oeps-tech/OE-PyBoard/Firmware/README.md

The firmware file was downloaded from the PyBoard v1.1 page: https://micropython.org/download/PYBV11/
