oeps-tech/OE-PyBoard/PCB/OE PyBoard FootprintLib/SW_SPST_TL3305B.step

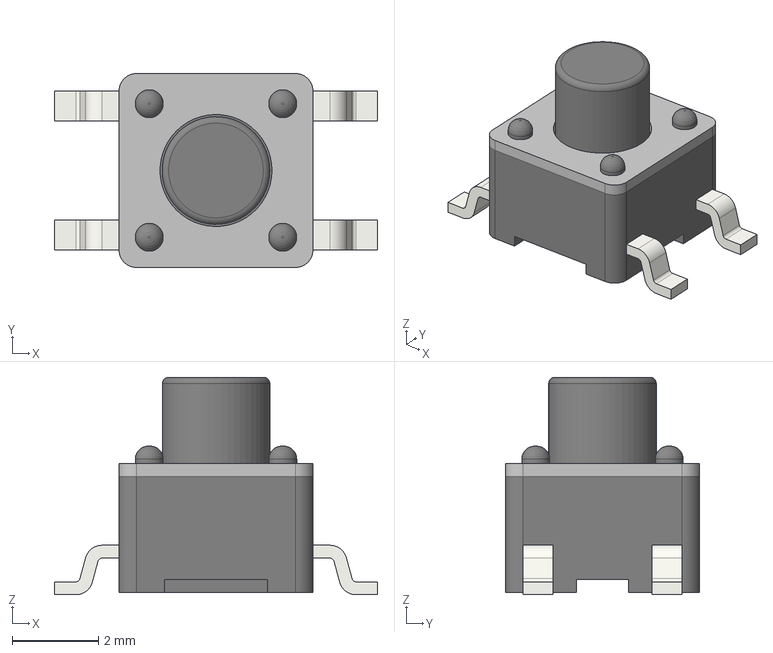
[picture p1: CAD file, 2025-09-24]
PCB/OE PyBoard FootprintLib/SW_SPST_TL3305B.step
7.50 x 4.50 x 5.05 mm
