oeps-tech/OE-PyBoard/PCB/OE PyBoard FootprintLib/ECS-.327-12.5-17X-C-TR.step

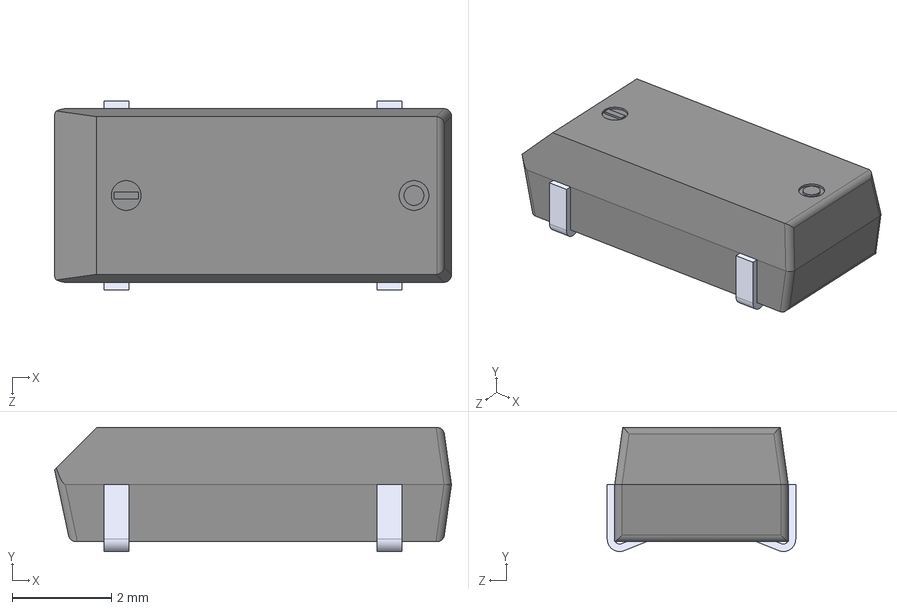
[picture p2: CAD file, 2025-09-12]
PCB/OE PyBoard FootprintLib/ECS-.327-12.5-17X-C-TR.step
8.00 x 2.50 x 3.80 mm
