oeps-tech/OE-PyBoard/PCB/OE PyBoard FootprintLib/475710001.stp

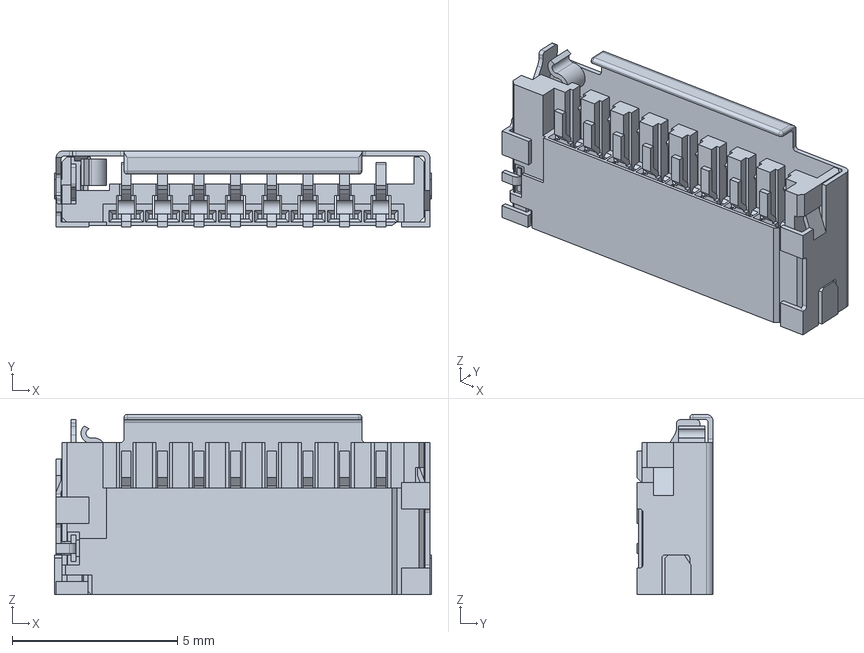
[picture p3: CAD file, 2025-09-12]
PCB/OE PyBoard FootprintLib/475710001.stp
11.4 x 2.30 x 5.45 mm
