oeps-tech/OE-PyBoard/PCB/OE PyBoard.kicad_pcb

## KiCad design PCB/OE PyBoard.kicad_pcb (2025-11-24)

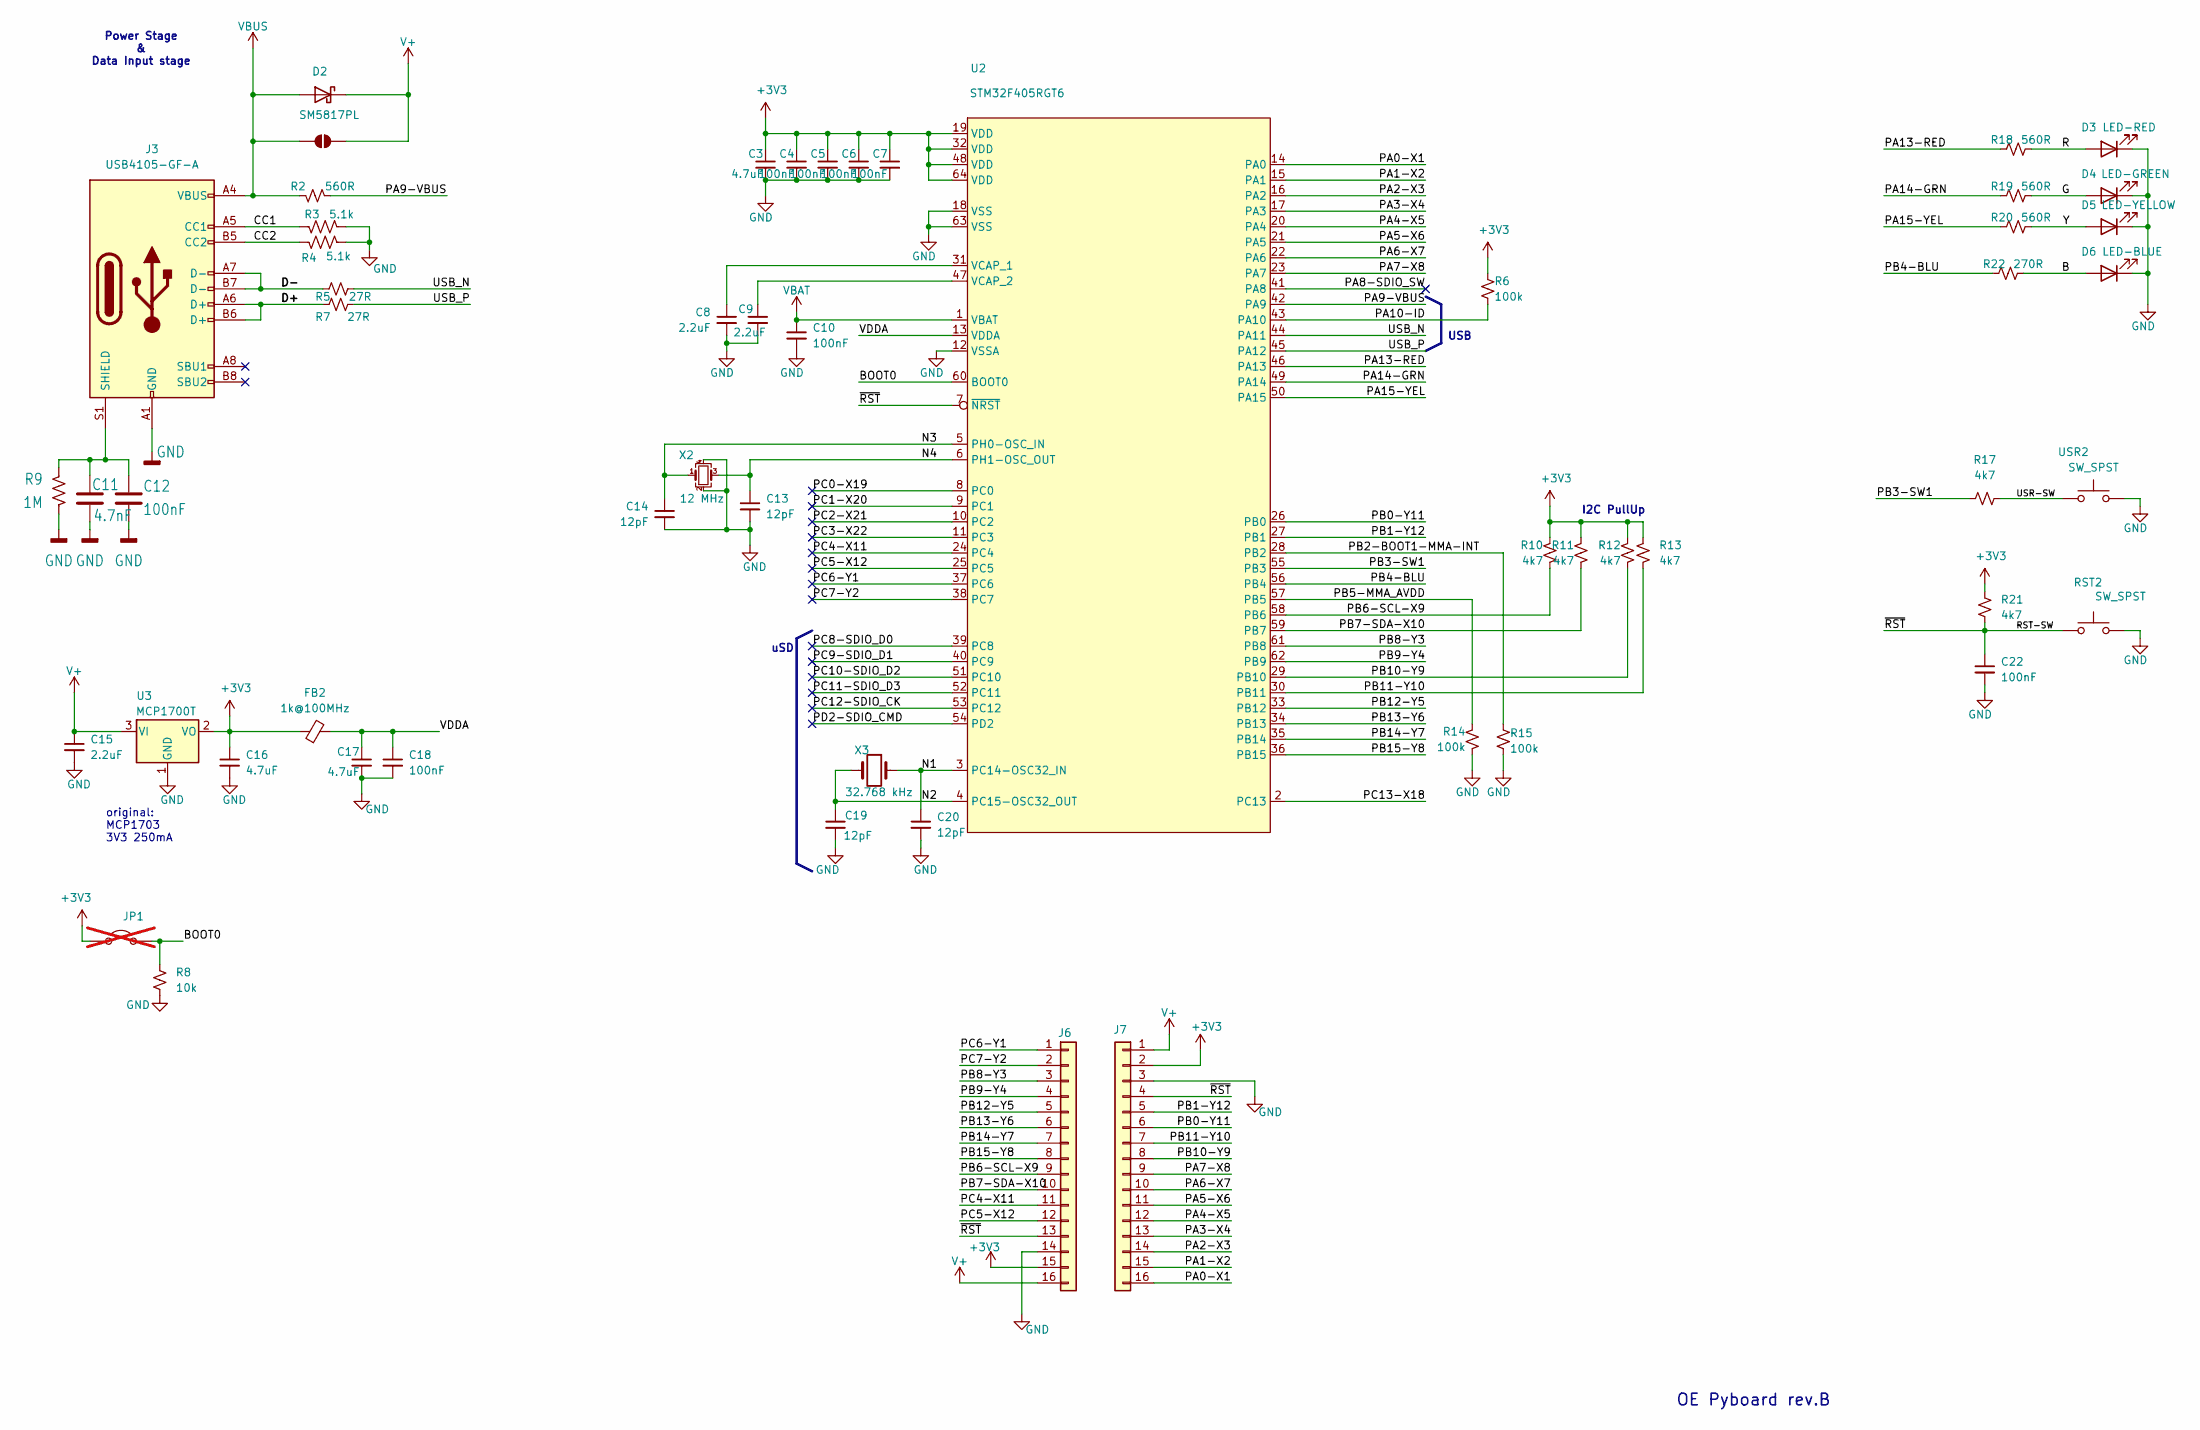
[picture p4: schematic OE PyBoard.kicad_sch]

Parts:
C3, C16, C17: 4.7uF; C_0603_1608Metric; MPN C1608X6S1C475K080AC
C4, C5, C6, C7, C10, C12, C18, C22: 100nF; C_0402_1005Metric; MPN CGA2B3X7R1H104K050BB
C8, C9, C15: 2.2uF; C_0603_1608Metric; MPN GRM188R61E225KA12D
C11: 4.7nF; C_0402_1005Metric; MPN 885012205084
C13, C14, C19, C20: 12pF; C_0402_1005Metric; MPN GRM1555C1H120JA01D
D2: SM5817PL; D_SOD-123; MPN SM5817PL-TP
D3: LED-RED; LED_0603_1608Metric; MPN 5990010007F
D4: LED-GREEN; LED_0603_1608Metric; MPN LSM0603453V
D5: LED-YELLOW; LED_0603_1608Metric; MPN 5990040007F
D6: LED-BLUE; LED_0603_1608Metric; MPN 5988D90107F
FB2: 1k@100MHz; L_0402_1005Metric; MPN BLM15HD102SN1D
J3: USB4105-GF-A; USB_C_Receptacle_GCT_USB4105-xx-A_16P_TopMnt_Horizontal; MPN USB4105-GF-A
J6, J7: Conn_01x08; PinHeader_1x16_P2.54mm_Vertical; MPN CES-116-01-T-S
JP1: Jumper; PinHeader_1x02_P2.54mm_Vertical; not fitted
JP2: 0R; SolderJumper-2_P1.3mm_Open_RoundedPad1.0x1.5mm
R2, R18, R19, R20: 560R; R_0402_1005Metric; MPN CRCW0402560RFKED
R3, R4: 5.1k; R_0402_1005Metric; MPN ERJ-2RKF5101X
R5, R7: 27R; R_0402_1005Metric; MPN RMCF0402FT27R0
R6, R14, R15: 100k; R_0402_1005Metric; MPN AC0402FR-07100KL
R8: 10k; R_0402_1005Metric; MPN ERJ-2RKF1002X
R9: 1M; R_0402_1005Metric; MPN CRCW04021M00FKED
R10, R11, R12, R13, R17, R21: 4k7; R_0402_1005Metric; MPN ERJ-2RKF4701X
R22: 270R; R_0402_1005Metric; MPN CRCW0402270RFKEDC
RST2: SW_SPST; SW_SPST_TL3305B; MPN TL3305BF260QG
U2: STM32F405RGT6; LQFP-64_10x10mm_P0.5mm; MPN STM32F405RGT6
U3: MCP1700T; SOT-23; MPN MCP1700T-3302E/TT
USR2: SW_SPST; SW_SPST_TL3305B; MPN TL3305BF260QG
X2: 12 MHz; Crystal_SMD_Abracon_ABM8AIG-4Pin_3.2x2.5mm; MPN ABM8AIG-12.000MHZ-12-2Z-T3
X3: 32.768 kHz; Crystal_SMD_2012-2Pin_2.0x1.2mm_HandSoldering; MPN 9HT11-32.768KBZF-T

Connections:
+3V3: C3.1, C4.1, C5.1, C6.1, C7.1, C16.1, FB2.1, J6.15, J7.2, JP1.2 (B), R6.1, R10.1, R11.1, R12.1, R13.1, R21.2, U2.19 (VDD), U2.32 (VDD), U2.48 (VDD), U2.64 (VDD), U3.2 (VO)
/B: D6.2 (A), R22.2
/BOOT0: JP1.1 (A), R8.1, U2.60 (BOOT0)
/CC1: J3.A5 (CC1), R3.1
/CC2: J3.B5 (CC2), R4.1
/D+: J3.A6 (D+), J3.B6 (D+), R7.2
/D-: J3.A7 (D-), J3.B7 (D-), R5.2
/G: D4.2 (A), R19.2
/N3: C14.1, U2.5 (PH0-OSC_IN), X2.1
/N4: C13.1, U2.6 (PH1-OSC_OUT), X2.3
/PA0-X1: J7.16, U2.14 (PA0)
/PA1-X2: J7.15, U2.15 (PA1)
/PA2-X3: J7.14, U2.16 (PA2)
/PA3-X4: J7.13, U2.17 (PA3)
/PA4-X5: J7.12, U2.20 (PA4)
/PA5-X6: J7.11, U2.21 (PA5)
/PA6-X7: J7.10, U2.22 (PA6)
/PA7-X8: J7.9, U2.23 (PA7)
/PA8-SDIO_SW: U2.41 (PA8)
/PA9-VBUS: R2.1, U2.42 (PA9)
/PA10-ID: R6.2, U2.43 (PA10)
/PA13-RED: R18.1, U2.46 (PA13)
/PA14-GRN: R19.1, U2.49 (PA14)
/PA15-YEL: R20.1, U2.50 (PA15)
/PB0-Y11: J7.6, U2.26 (PB0)
/PB1-Y12: J7.5, U2.27 (PB1)
/PB2-BOOT1-MMA-INT: R15.1, U2.28 (PB2)
/PB3-SW1: R17.1, U2.55 (PB3)
/PB4-BLU: R22.1, U2.56 (PB4)
/PB5-MMA_AVDD: R14.1, U2.57 (PB5)
/PB6-SCL-X9: J6.9, R10.2, U2.58 (PB6)
/PB7-SDA-X10: J6.10, R11.2, U2.59 (PB7)
/PB8-Y3: J6.3, U2.61 (PB8)
/PB9-Y4: J6.4, U2.62 (PB9)
/PB10-Y9: J7.8, R12.2, U2.29 (PB10)
/PB11-Y10: J7.7, R13.2, U2.30 (PB11)
/PB12-Y5: J6.5, U2.33 (PB12)
/PB13-Y6: J6.6, U2.34 (PB13)
/PB14-Y7: J6.7, U2.35 (PB14)
/PB15-Y8: J6.8, U2.36 (PB15)
/PC0-X19: U2.8 (PC0)
/PC1-X20: U2.9 (PC1)
/PC2-X21: U2.10 (PC2)
/PC3-X22: U2.11 (PC3)
/PC4-X11: J6.11, U2.24 (PC4)
/PC5-X12: J6.12, U2.25 (PC5)
/PC6-Y1: J6.1, U2.37 (PC6)
/PC7-Y2: J6.2, U2.38 (PC7)
/PC8-SDIO_D0: U2.39 (PC8)
/PC9-SDIO_D1: U2.40 (PC9)
/PC10-SDIO_D2: U2.51 (PC10)
/PC11-SDIO_D3: U2.52 (PC11)
/PC12-SDIO_CK: U2.53 (PC12)
/PC13-X18: U2.2 (PC13)
/PD2-SDIO_CMD: U2.54 (PD2)
/R: D3.2 (A), R18.2
/RST-SW: C22.1, J6.13, J7.4, R21.1, RST2.1, U2.7 (~NRST)
/USB_N: R5.1, U2.44 (PA11)
/USB_P: R7.1, U2.45 (PA12)
/USR-SW: R17.2, USR2.1
/VDDA: C17.1, C18.1, FB2.2, U2.13 (VDDA)
/Y: D5.2 (A), R20.2
GND: C3.2, C4.2, C5.2, C6.2, C7.2, C8.2, C9.2, C10.2, C11.2, C12.1, C13.2, C14.2, C15.2, C16.2, C17.2, C18.2, C19.2, C20.2, C22.2, D3.1 (K), D4.1 (K), D5.1 (K), D6.1 (K), J3.A1 (GND), J3.A12 (GND), J3.B1 (GND), J3.B12 (GND), J6.14, J7.3, R3.2, R4.2, R8.2, R9.1, R14.2, R15.2, RST2.2, U2.12 (VSSA), U2.18 (VSS), U2.63 (VSS), U3.1 (GND), USR2.2, X2.2, X2.4
unnamed: C11.1, C12.2, J3.S1 (SHIELD), R9.2
unnamed: C8.1, U2.31 (VCAP_1)
unnamed: C9.1, U2.47 (VCAP_2)
V+: C15.1, D2.1 (K), J6.16, J7.1, JP2.2 (B), U3.3 (VI)
VBAT: C10.1, U2.1 (VBAT)
VBUS: D2.2 (A), J3.A4 (VBUS), J3.A9 (VBUS), J3.B4 (VBUS), J3.B9 (VBUS), JP2.1 (A), R2.2

Notes on the sheet:
I2C PullUp
USB
original: MCP1703 3V3 250mA
uSD
OE Pyboard rev.B
Power Stage & Data Input stage

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
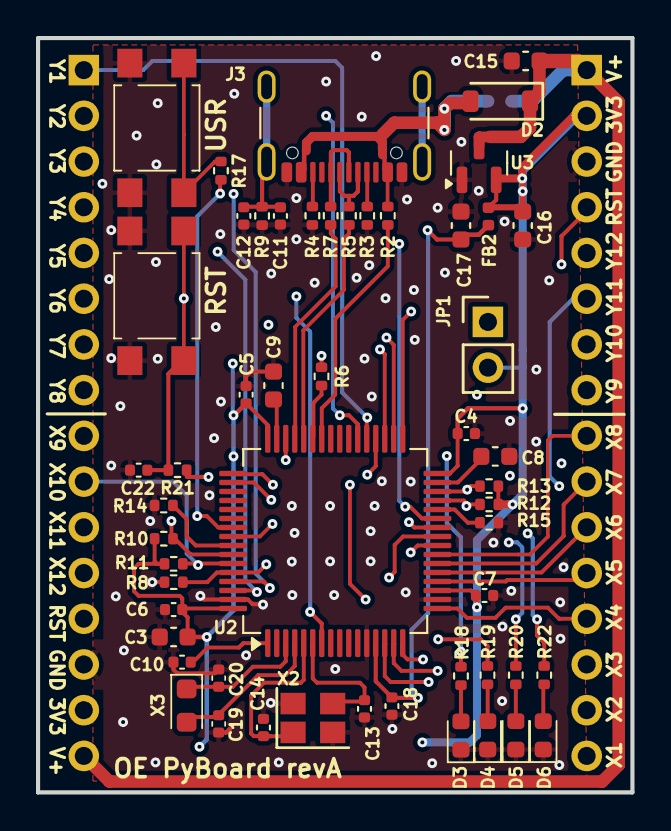
[picture p5: board OE PyBoard.kicad_pcb from above]

Board: 4 copper layers, 33.0 x 41.9 mm, 56 parts (1 on the bottom side), 59 nets.
