oeps-tech/OE-PyBoard/(commit log)

2025-08-28 Added .gitignore for KiCad project files
    Introduces a .gitignore file tailored for KiCad PCB design projects, excluding temporary, backup, netlist, autorouter, and exported BOM files to keep the repository clean.
2025-09-12 Added OE PyBoard initial KiCad project files
    Initial commit of OE PyBoard project including schematic, PCB, symbol and footprint libraries, 3D models, BOM, position files, drill files, and Gerber files for production.
    [475710001.stp, ECS-.327-12.5-17X-C-TR.step, OE PyBoard BOM.csv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]
2025-09-24 Added 3D model for SW_SPST_TL3305B and updated PCB
    [OE PyBoard.kicad_pcb, SW_SPST_TL3305B.step]
2025-09-25 Replaced D3 obsolete red LED in schematic, PCB, and BOM.
    [OE PyBoard BOM.csv, OE PyBoard.kicad_pcb, OE PyBoard.kicad_sch]
2025-10-02 Moved PyBoard files into PCB directory
    Renamed and reorganized all OE PyBoard-related files and production outputs into the PCB directory for improved project structure and clarity.
    [475710001.stp, ECS-.327-12.5-17X-C-TR.step, OE PyBoard BOM.csv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]
2025-10-09 Fixed cristal and diode's footprint.
    Also, updated the production files.
    [OE PyBoard BOM.csv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]
2025-11-12 Isolated used analog lines and moved buttons
    Note: Gerbers and PnP files are not updated.
    [OE PyBoard.kicad_pcb]
2025-11-24 Updated production files.
    [OE PyBoard-B_Cu.gbr, OE PyBoard-B_Fab.gbr, OE PyBoard-B_Mask.gbr, OE PyBoard-B_Paste.gbr, OE PyBoard-B_Silkscreen.gbr, OE PyBoard-Edge_Cuts.gbr, OE PyBoard-F_Cu.gbr, OE PyBoard-F_Fab.gbr]
2025-11-24 Removed board stackup table from F.Fab layer
    Updated Gerber files to reflect these change.
    [OE PyBoard-B_Cu.gbr, OE PyBoard-B_Fab.gbr, OE PyBoard-B_Mask.gbr, OE PyBoard-B_Paste.gbr, OE PyBoard-B_Silkscreen.gbr, OE PyBoard-Edge_Cuts.gbr, OE PyBoard-F_Cu.gbr, OE PyBoard-F_Fab.gbr]
